iskyguy/esp32c6-claude-sht4x/docs/pcb-back-copper.png

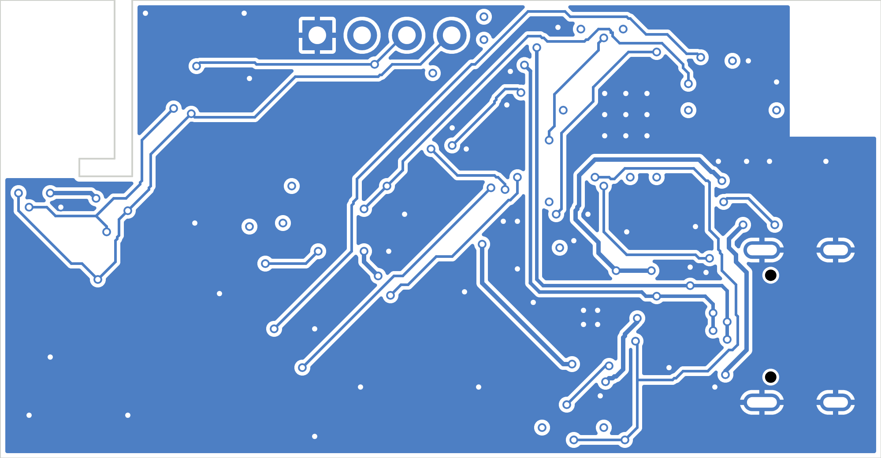
docs/pcb-back-copper.png
