iskyguy/esp32c6-claude-sht4x/docs/pcb-bottom.png

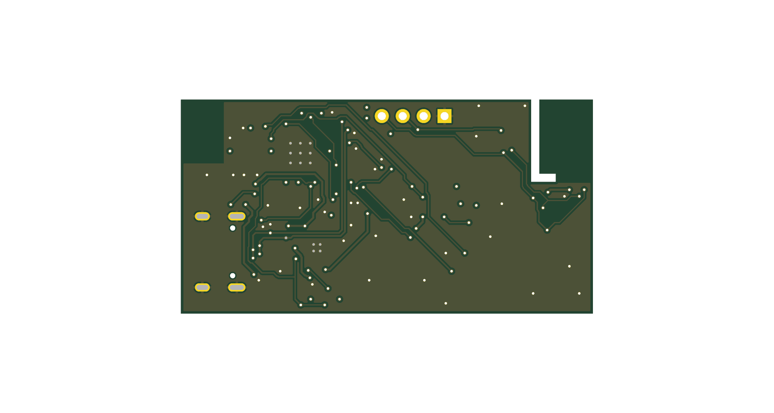
docs/pcb-bottom.png
