iskyguy/esp32c6-claude-sht4x/docs/pcb-front-copper.png

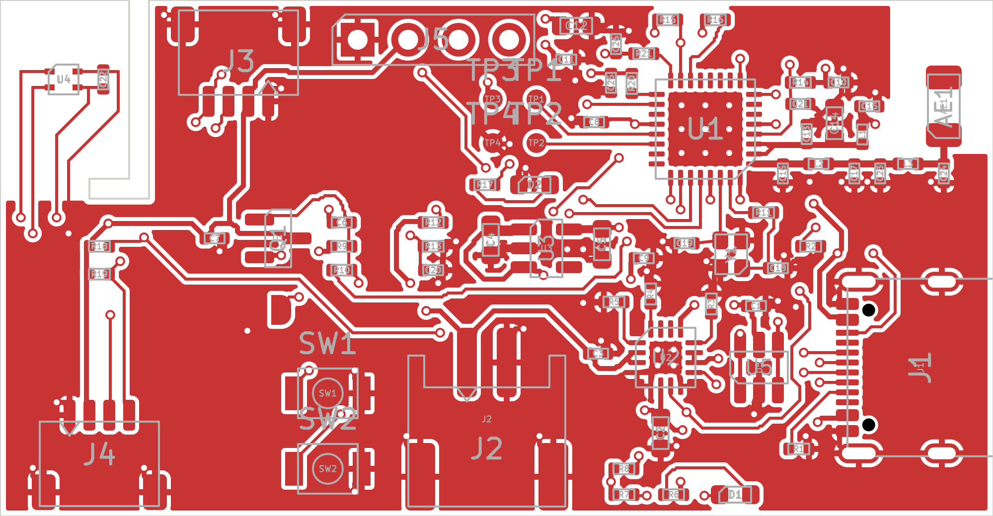
docs/pcb-front-copper.png
