iskyguy/esp32c6-claude-sht4x/docs/bom.csv

Reference | Value | Footprint | MPN | Spec | QUANTITY | DNP
AE1 | 2450AT18A100E | RF_Antenna:Johanson_2450AT18x100 | Johanson 2450AT18A100E |  | 1
C1 | 1u | Capacitor_SMD:C_0402_1005Metric |  | 25V X5R 10% | 1
C2,C4,C5,C12,C14 | 10u | Capacitor_SMD:C_0603_1608Metric |  | 10V X5R 20%, >=4.7u effective at 4.4V bias | 5
C3 | 4.7u | Capacitor_SMD:C_0402_1005Metric |  | 10V X5R 10% | 1
C6,C8-C10,C13,C20,C22 | 100n | Capacitor_SMD:C_0402_1005Metric |  | 16V X7R 10% | 7
C7,C11,C15,C21 | 1u | Capacitor_SMD:C_0402_1005Metric |  | 10V X5R 10% | 4
C16,C17 | 1.5p (tune) | Capacitor_SMD:C_0402_1005Metric |  | 50V C0G +/-0.1pF | 2
C18,C19 | 12p | Capacitor_SMD:C_0402_1005Metric |  | 50V C0G 5% | 2
C23-C26 | DNP | Capacitor_SMD:C_0402_1005Metric |  | 50V C0G | 4 | DNP
D1 | CHG (red) | LED_SMD:LED_0603_1608Metric |  |  | 1
D2 | STATUS (green) | LED_SMD:LED_0603_1608Metric |  |  | 1
J1 | USB-C 16P | Connector_USB:USB_C_Receptacle_GCT_USB4105-xx-A_16P_TopMnt_Horizontal | GCT USB4105-GF-A |  | 1
J2 | BATT JST-PH | Connector_JST:JST_PH_S2B-PH-SM4-TB_1x02-1MP_P2.00mm_Horizontal | JST S2B-PH-SM4-TB |  | 1
J3,J4 | QWIIC | Connector_JST:JST_SH_SM04B-SRSS-TB_1x04-1MP_P1.00mm_Horizontal | JST SM04B-SRSS-TB |  | 2
J5 | OLED 1x4 | Connector_PinSocket_2.54mm:PinSocket_1x04_P2.54mm_Vertical |  |  | 1
JP1 | ALWAYS ON | Jumper:SolderJumper-2_P1.3mm_Open_RoundedPad1.0x1.5mm |  |  | 1
L1 | 2.0nH | Inductor_SMD:L_0402_1005Metric |  | RF multilayer, high Q | 1
L2 | 2.0nH (tune) | Inductor_SMD:L_0402_1005Metric |  | RF multilayer, high Q | 1
L3 | 0R (tune) | Inductor_SMD:L_0402_1005Metric |  | 0R jumper or RF inductor after tuning | 1
Q1 | AO3401A | Package_TO_SOT_SMD:SOT-23 |  |  | 1
R1,R2 | 5.1k | Resistor_SMD:R_0402_1005Metric |  | 1% 1/16W | 2
R3 | 1.5k | Resistor_SMD:R_0402_1005Metric |  | 1% 1/16W | 1
R4 | 3.6k | Resistor_SMD:R_0402_1005Metric |  | 1% 1/16W | 1
R5,R10,R14-R16 | 10k | Resistor_SMD:R_0402_1005Metric |  | 1% 1/16W | 5
R6,R17 | 1k | Resistor_SMD:R_0402_1005Metric |  | 1% 1/16W | 2
R7-R9 | 100k | Resistor_SMD:R_0402_1005Metric |  | 1% 1/16W | 3
R11 | 0R | Resistor_SMD:R_0402_1005Metric |  | 1% 1/16W | 1
R12,R13 | 1M | Resistor_SMD:R_0402_1005Metric |  | 1% 1/16W | 2
R18,R19 | 4.7k | Resistor_SMD:R_0402_1005Metric |  | 1% 1/16W | 2
R20,R21 | 0R | Resistor_SMD:R_0402_1005Metric |  | 0R jumper (USB series tuning) | 2
SW1 | RESET | Button_Switch_SMD:SW_SPST_B3U-1000P |  |  | 1
SW2 | BOOT | Button_Switch_SMD:SW_SPST_B3U-1000P |  |  | 1
TP1 | U0TXD | TestPoint:TestPoint_Pad_D1.0mm |  |  | 1
TP2 | U0RXD | TestPoint:TestPoint_Pad_D1.0mm |  |  | 1
TP3 | 3V3 | TestPoint:TestPoint_Pad_D1.0mm |  |  | 1
TP4 | GND | TestPoint:TestPoint_Pad_D1.0mm |  |  | 1
U1 | ESP32-C6FH8 | Package_DFN_QFN:QFN-32-1EP_5x5mm_P0.5mm_EP3.6x3.6mm | ESP32-C6FH8 |  | 1
U2 | BQ24074RGTR | Package_DFN_QFN:VQFN-16-1EP_3x3mm_P0.5mm_EP1.6x1.6mm |  |  | 1
U3 | XC6220B331MR | Package_TO_SOT_SMD:SOT-23-5 |  |  | 1
U4 | SHT41-AD1B | Sensor_Humidity:Sensirion_DFN-4_1.5x1.5mm_P0.8mm_SHT4x_NoCentralPad |  |  | 1
U5 | USBLC6-2SC6 | Package_TO_SOT_SMD:SOT-23-6 |  |  | 1
Y1 | 40MHz 10ppm CL=10pF | Crystal:Crystal_SMD_2016-4Pin_2.0x1.6mm |  |  | 1
