iskyguy/esp32c6-claude-sht4x/docs/schematic.pdf

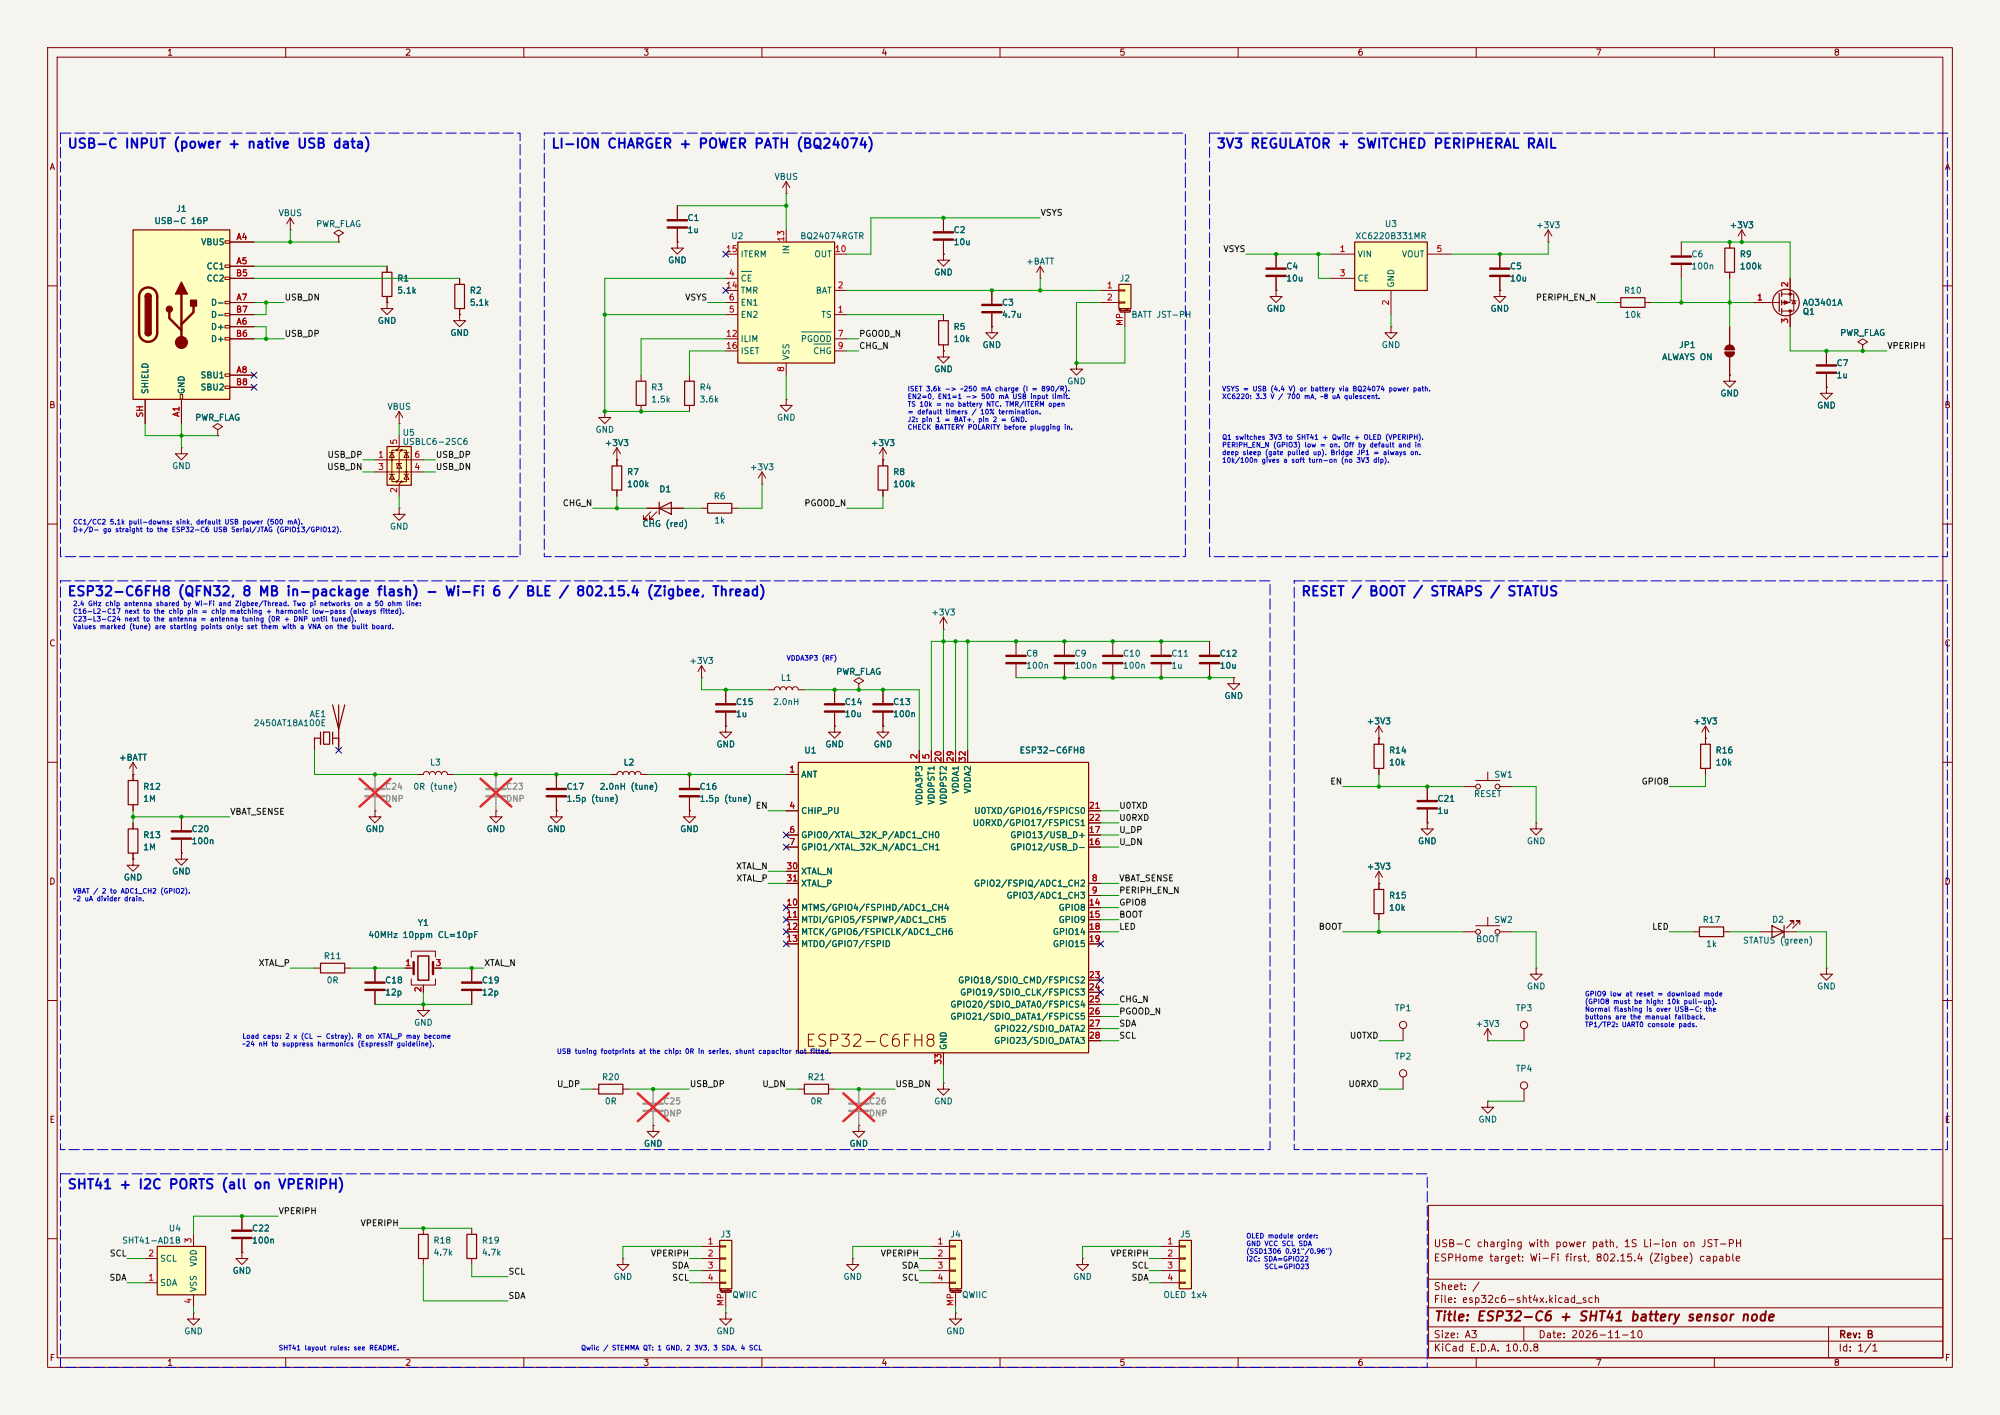
[picture p6: page 1]

USB-C INPUT (power + native USB data)
J1 USB-C 16P GND A1

ISET 3.6k -> ~250 mA charge (I = 890/R). EN2=0, EN1=1 -> 500 mA USB input limit. TS 10k = no battery NTC. TMR/ITERM open = default timers / 10% termination. J2: pin 1 = BAT+, pin 2 = GND. CHECK BATTERY POLARITY before plugging in.

Q1 switches 3V3 to SHT41 + Qwiic + OLED (VPERIPH). PERIPH_EN_N (GPIO3) low = on. Off by default and in

ESP32-C6FH8 (QFN32, 8 MB in-package flash) - Wi-Fi 6 / BLE / 802.15.4 (Zigbee, Thread)

RESET / BOOT / STRAPS / STATUS

5 GPIO0/XTAL_32K_P/ADC1_CH0 6 GPIO1/XTAL_32K_N/ADC1_CH1 7 GPIO2/FSPIQ/ADC1_CH2 8 GPIO3/ADC1_CH3 9 MTMS/GPIO4/FSPIHD/ADC1_CH4 10 MTDI/GPIO5/FSPIWP/ADC1_CH5 11 MTCK/GPIO6/FSPICLK/ADC1_CH6 12 MTDO/GPIO7/FSPID 13 GPIO8 14 GPIO9 15 GPIO12/USB_D- 16 GPIO13/USB_D+ 17 GPIO14 18 GPIO15 19 VDDPST2 20

~24 nH to suppress harmonics (Espressif guideline). VBAT / 2 to ADC1_CH2 (GPIO2). ~2 uA divider drain.

(GPIO8 must be high: 10k pull-up). Normal flashing is over USB-C; the buttons are the manual fallback. TP1/TP2: UART0 console pads.

Load caps: 2 x (CL - Cstray). R on XTAL_P may become

SHT41 layout rules: see README. SHT41 + I2C PORTS (all on VPERIPH)

OLED module order: GND VCC SCL SDA

USB-C charging with power path, 1S Li-ion on JST-PH
ESPHome target: Wi-Fi first, 802.15.4 (Zigbee) capable

Sheet: /
File: esp32c6-sht4x.kicad_sch
Title: ESP32-C6 + SHT41 battery sensor node

Size: A3 | Rev: B | F Date: 2026-11-10
KiCad E.D.A. 10.0.8 | Id: 1/1

Qwiic / STEMMA QT: 1 GND, 2 3V3, 3 SDA, 4 SCL
