iskyguy/esp32c6-claude-sht4x/hardware/esp32c6-sht4x.kicad_pcb

## KiCad design hardware/esp32c6-sht4x.kicad_pcb (2026-11-10)

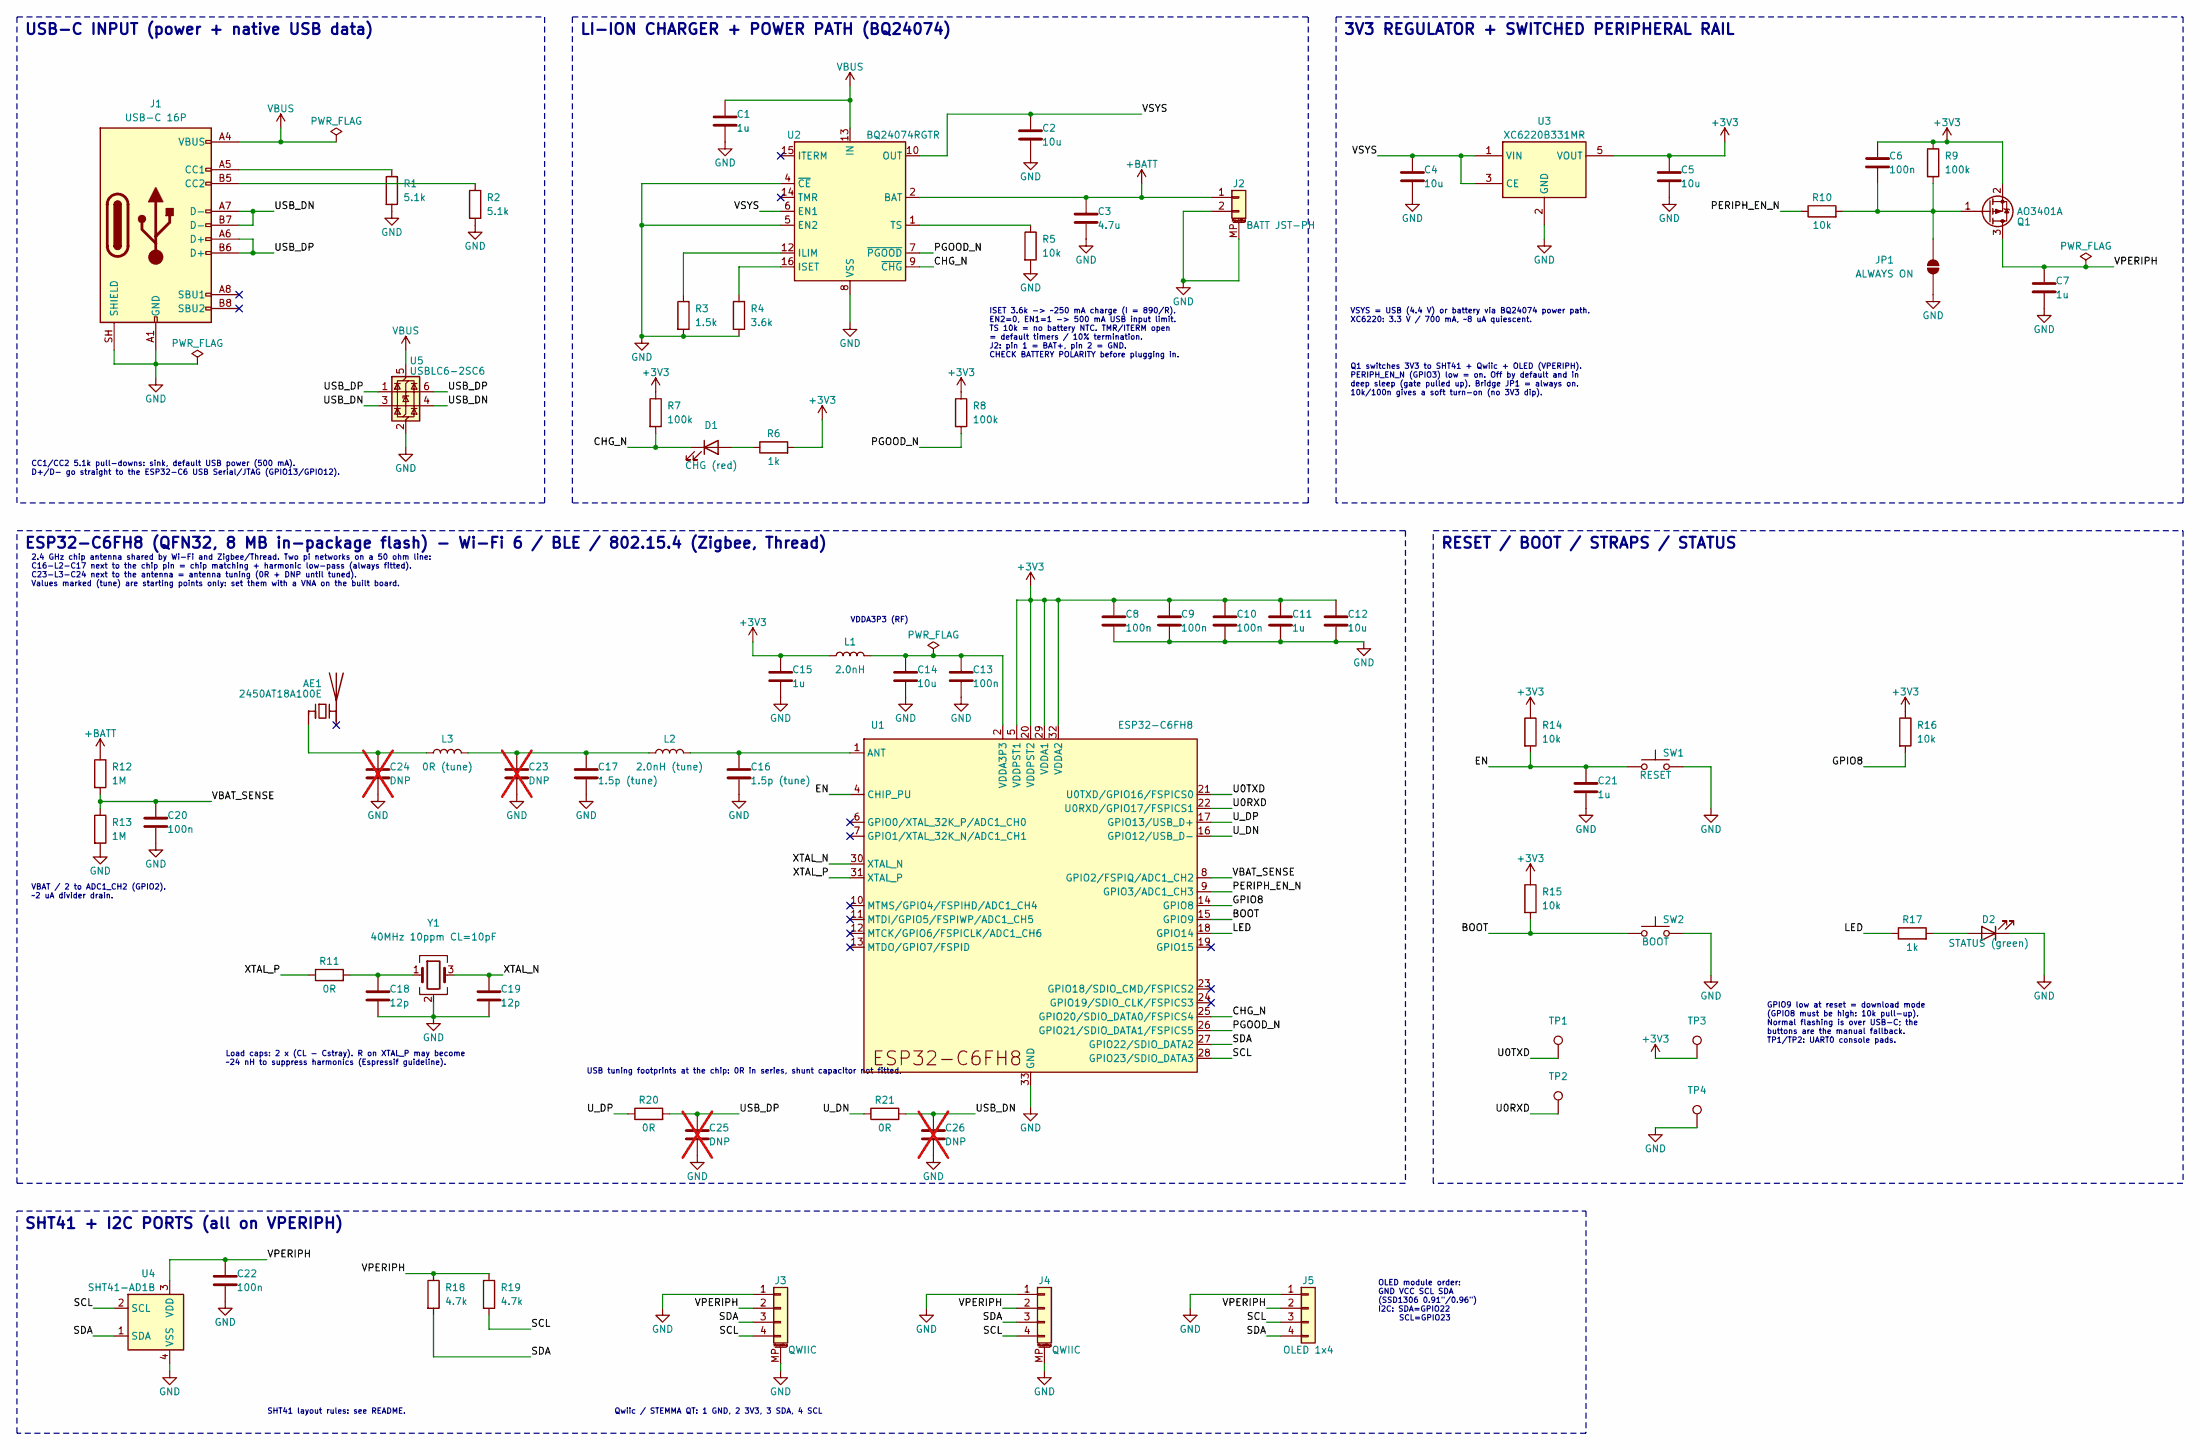
[picture p7: schematic esp32c6-sht4x.kicad_sch, ESP32-C6 + SHT41 battery sensor node]

Parts:
AE1: 2450AT18A100E; Johanson_2450AT18x100; MPN Johanson 2450AT18A100E
C1, C7, C11, C15, C21: 1u; C_0402_1005Metric
C2, C4, C5, C12, C14: 10u; C_0603_1608Metric
C3: 4.7u; C_0402_1005Metric
C6, C8, C9, C10, C13, C20, C22: 100n; C_0402_1005Metric
C16, C17: 1.5p (tune); C_0402_1005Metric
C18, C19: 12p; C_0402_1005Metric
C23, C24, C25, C26: DNP; C_0402_1005Metric; not fitted
D1: CHG (red); LED_0603_1608Metric
D2: STATUS (green); LED_0603_1608Metric
J1: USB-C 16P; USB_C_Receptacle_GCT_USB4105-xx-A_16P_TopMnt_Horizontal; MPN GCT USB4105-GF-A
J2: BATT JST-PH; JST_PH_S2B-PH-SM4-TB_1x02-1MP_P2.00mm_Horizontal; MPN JST S2B-PH-SM4-TB
J3, J4: QWIIC; JST_SH_SM04B-SRSS-TB_1x04-1MP_P1.00mm_Horizontal; MPN JST SM04B-SRSS-TB
J5: OLED 1x4; PinSocket_1x04_P2.54mm_Vertical
JP1: ALWAYS ON; SolderJumper-2_P1.3mm_Open_RoundedPad1.0x1.5mm
L1: 2.0nH; L_0402_1005Metric
L2: 2.0nH (tune); L_0402_1005Metric
L3: 0R (tune); L_0402_1005Metric
Q1: AO3401A; SOT-23
R1, R2: 5.1k; R_0402_1005Metric
R3: 1.5k; R_0402_1005Metric
R4: 3.6k; R_0402_1005Metric
R5, R10, R14, R15, R16: 10k; R_0402_1005Metric
R6, R17: 1k; R_0402_1005Metric
R7, R8, R9: 100k; R_0402_1005Metric
R11, R20, R21: 0R; R_0402_1005Metric
R12, R13: 1M; R_0402_1005Metric
R18, R19: 4.7k; R_0402_1005Metric
SW1: RESET; SW_SPST_B3U-1000P
SW2: BOOT; SW_SPST_B3U-1000P
TP1: U0TXD; TestPoint_Pad_D1.0mm
TP2: U0RXD; TestPoint_Pad_D1.0mm
TP3: 3V3; TestPoint_Pad_D1.0mm
TP4: GND; TestPoint_Pad_D1.0mm
U1: ESP32-C6FH8; QFN-32-1EP_5x5mm_P0.5mm_EP3.6x3.6mm; MPN ESP32-C6FH8
U2: BQ24074RGTR; VQFN-16-1EP_3x3mm_P0.5mm_EP1.6x1.6mm
U3: XC6220B331MR; SOT-23-5
U4: SHT41-AD1B; Sensirion_DFN-4_1.5x1.5mm_P0.8mm_SHT4x_NoCentralPad
U5: USBLC6-2SC6; SOT-23-6
Y1: 40MHz 10ppm CL=10pF; Crystal_SMD_2016-4Pin_2.0x1.6mm

Connections:
+3V3: C5.1, C6.1, C8.1, C9.1, C10.1, C11.1, C12.1, C15.1, L1.1, Q1.2 (S), R6.2, R7.1, R8.1, R9.1, R14.1, R15.1, R16.1, TP3.1, U1.5 (VDDPST1), U1.20 (VDDPST2), U1.29 (VDDA1), U1.32 (VDDA2), U3.5 (VOUT)
+BATT: C3.1, J2.1, R12.1, U2.2 (BAT), U2.3 (BAT)
/BOOT: R15.2, SW2.1, U1.15 (GPIO9)
/CHG_N: D1.1 (K), R7.2, U1.25 (GPIO20/SDIO_DATA0/FSPICS4), U2.9 (~CHG)
/EN: C21.1, R14.2, SW1.1, U1.4 (CHIP_PU)
/GPIO8: R16.2, U1.14 (GPIO8)
/LED: R17.1, U1.18 (GPIO14)
/PERIPH_EN_N: R10.1, U1.9 (GPIO3/ADC1_CH3)
/PGOOD_N: R8.2, U1.26 (GPIO21/SDIO_DATA1/FSPICS5), U2.7 (~PGOOD)
/SCL: J3.4, J4.4, J5.3, R19.2, U1.28 (GPIO23/SDIO_DATA3), U4.2 (SCL)
/SDA: J3.3, J4.3, J5.4, R18.2, U1.27 (GPIO22/SDIO_DATA2), U4.1 (SDA)
/U0RXD: TP2.1, U1.22 (U0RXD/GPIO17/FSPICS1)
/U0TXD: TP1.1, U1.21 (U0TXD/GPIO16/FSPICS0)
/USB_DN: C26.1, J1.A7 (D-), J1.B7 (D-), R21.2, U5.3 (I/O2), U5.4 (I/O2)
/USB_DP: C25.1, J1.A6 (D+), J1.B6 (D+), R20.2, U5.1 (I/O1), U5.6 (I/O1)
/U_DN: R21.1, U1.16 (GPIO12/USB_D-)
/U_DP: R20.1, U1.17 (GPIO13/USB_D+)
/VBAT_SENSE: C20.1, R12.2, R13.1, U1.8 (GPIO2/FSPIQ/ADC1_CH2)
/VPERIPH: C7.1, C22.1, J3.2, J4.2, J5.2, Q1.3 (D), R18.1, R19.1, U4.3 (VDD)
/VSYS: C2.1, C4.1, U2.6 (EN1), U2.10 (OUT), U2.11 (OUT), U3.1 (VIN), U3.3 (CE)
/XTAL_N: C19.1, U1.30 (XTAL_N), Y1.3
/XTAL_P: R11.1, U1.31 (XTAL_P)
GND: C1.2, C2.2, C3.2, C4.2, C5.2, C7.2, C8.2, C9.2, C10.2, C11.2, C12.2, C13.2, C14.2, C15.2, C16.2, C17.2, C18.2, C19.2, C20.2, C21.2, C22.2, C23.2, C24.2, C25.2, C26.2, D2.1 (K), J1.A1 (GND), J1.A12 (GND), J1.B1 (GND), J1.B12 (GND), J1.SH (SHIELD), J2.2, J2.MP (MountPin), J3.1, J3.MP (MountPin), J4.1, J4.MP (MountPin), J5.1, JP1.1 (A), R1.2, R2.2, R3.2, R4.2, R5.2, R13.2, SW1.2, SW2.2, TP4.1, U1.33 (GND), U2.4 (~CE), U2.5 (EN2), U2.8 (VSS), U2.17 (VSS), U3.2 (GND), U4.4 (VSS), U5.2 (GND), Y1.2 (G), Y1.4 (G)
unnamed: AE1.1 (FEED), C24.1, L3.1
unnamed: C13.1, C14.1, L1.2, U1.2 (VDDA3P3), U1.3 (VDDA3P3)
unnamed: C17.1, C23.1, L2.1, L3.2
unnamed: C18.1, R11.2, Y1.1
unnamed: D1.2 (A), R6.1
unnamed: D2.2 (A), R17.2
unnamed: J1.A5 (CC1), R1.1
unnamed: J1.B5 (CC2), R2.1
unnamed: C6.2, JP1.2 (B), Q1.1 (G), R9.2, R10.2
unnamed: C16.1, L2.2, U1.1 (ANT)
unnamed: R3.1, U2.12 (ILIM)
unnamed: R4.1, U2.16 (ISET)
unnamed: R5.1, U2.1 (TS)
VBUS: C1.1, J1.A4 (VBUS), J1.A9 (VBUS), J1.B4 (VBUS), J1.B9 (VBUS), U2.13 (IN), U5.5 (VBUS)

Notes on the sheet:
Qwiic / STEMMA QT: 1 GND, 2 3V3, 3 SDA, 4 SCL
Q1 switches 3V3 to SHT41 + Qwiic + OLED (VPERIPH). PERIPH_EN_N (GPIO3) low = on. Off by default and in deep sleep (gate pulled up). Bridge JP1 = always on. 10k/100n gives a soft turn-on (no 3V3 dip).
VDDA3P3 (RF)
OLED module order: GND VCC SCL SDA (SSD1306 0.91"/0.96") I2C: SDA=GPIO22 SCL=GPIO23
SHT41 + I2C PORTS (all on VPERIPH)
ESP32-C6FH8 (QFN32, 8 MB in-package flash) - Wi-Fi 6 / BLE / 802.15.4 (Zigbee, Thread)
VSYS = USB (4.4 V) or battery via BQ24074 power path. XC6220: 3.3 V / 700 mA, ~8 uA quiescent.
2.4 GHz chip antenna shared by Wi-Fi and Zigbee/Thread. Two pi networks on a 50 ohm line: C16-L2-C17 next to the chip pin = chip matching + harmonic low-pass (always fitted). C23-L3-C24 next to the antenna = antenna tuning (0R + DNP until tuned). Values marked (tune) are starting points only: set t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
USB-C INPUT (power + native USB data)
ISET 3.6k -> ~250 mA charge (I = 890/R). EN2=0, EN1=1 -> 500 mA USB input limit. TS 10k = no battery NTC. TMR/ITERM open = default timers / 10% termination. J2: pin 1 = BAT+, pin 2 = GND. CHECK BATTERY POLARITY before plugging in.
CC1/CC2 5.1k pull-downs: sink, default USB power (500 mA). D+/D- go straight to the ESP32-C6 USB Serial/JTAG (GPIO13/GPIO12).
LI-ION CHARGER + POWER PATH (BQ24074)
Load caps: 2 x (CL - Cstray). R on XTAL_P may become ~24 nH to suppress harmonics (Espressif guideline).
GPIO9 low at reset = download mode (GPIO8 must be high: 10k pull-up). Normal flashing is over USB-C; the buttons are the manual fallback. TP1/TP2: UART0 console pads.
3V3 REGULATOR + SWITCHED PERIPHERAL RAIL
RESET / BOOT / STRAPS / STATUS
SHT41 layout rules: see README.
USB tuning footprints at the chip: 0R in series, shunt capacitor not fitted.
VBAT / 2 to ADC1_CH2 (GPIO2). ~2 uA divider drain.

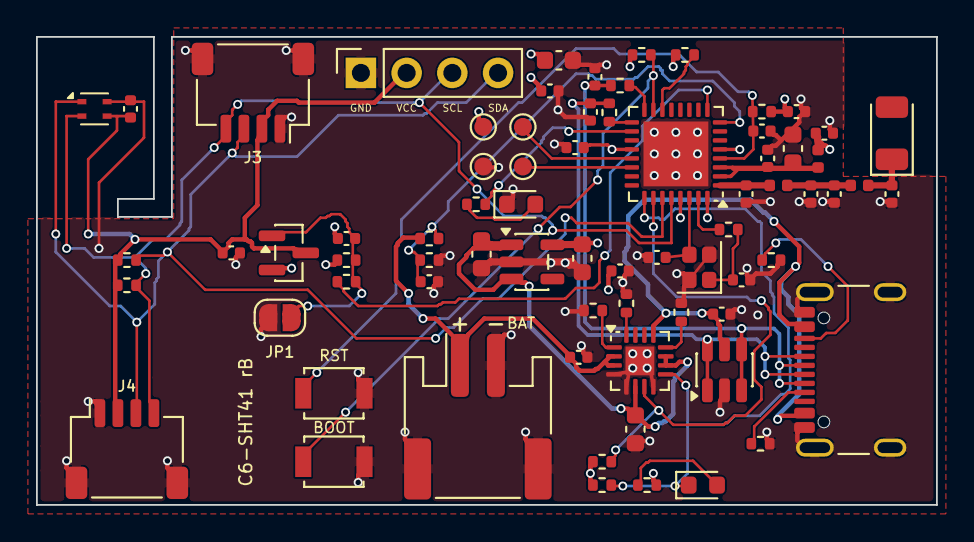
[picture p8: board esp32c6-sht4x.kicad_pcb from above]

Board: 4 copper layers, 50.0 x 26.0 mm, 72 parts (0 on the bottom side), 37 nets.
