iskyguy/esp32c6-claude-sht4x/(commit log)

2026-11-10 Add KiCad 10 schematic for ESP32-C6 + SHT41 battery sensor node
    Bare ESP32-C6FH8 with chip antenna, USB-C with native USB data,
    BQ24074 charger with power path, XC6220 3V3 regulator, SHT41 on a
    switched peripheral rail, two Qwiic ports, OLED header and JST-PH
    battery connector. ERC passes with 0 violations in KiCad 10.0.8.
    Claude-Session: https://claude.ai/code/session_01C47fZqrf17BFC1QzWHG2p7
    [bom.csv, esp32c6-sht4x.kicad_sch]
2026-11-10 Add first-pass 4-layer PCB layout
    50 x 26 mm board with the SHT41 on a slotted, copper-free peninsula,
    chip antenna in a cleared corner, ground and 3V3 inner planes.
    DRC in KiCad 10.0.8: 0 violations, 0 unconnected, schematic parity clean.
    Also drops stray library-only fields from the schematic symbols and
    adds the generator scripts under tools/.
    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
    [esp32c6-sht4x.kicad_pcb, esp32c6-sht4x.kicad_sch]
2026-11-10 Revision B: apply design review to schematic and PCB
    - Fit chip-side RF matching network, add antenna tuning network
    - Move ground edge up to the antenna feed pad
    - 10 uF regulator input cap, caps placed at the regulator pins
    - RF supply: wider trace, bulk capacitance after L1, 9 exposed-pad vias
    - Crystal routed on the top layer only, guarded on the bottom layer
    - USB routed as a pair with series/shunt tuning footprints at the chip
    - EN pull-up and capacitor next to CHIP_PU
    - BOM gains a Spec column
    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
    [bom.csv, esp32c6-sht4x.kicad_pcb, esp32c6-sht4x.kicad_sch]
